aesirkth/launchpad-controller/(threads)

Thread 1 (2019-10-31):

Add new commands

wanysteus, 2019-10-31:
More commands must be added for Sigmundr

- Start the rocket fueling
- Ignite the rocket's engine
- Arm
- Defueling
- Activate/deactivate telemetry and FPV transmitters
- Start sensors calibration

Closed 2019-11-21.

Thread 13 (2020-08-28):

RadioHead library out of date

wanysteus, 2020-08-28:
We're currently using radiohead `1.61` modified by Paul Stoffregen [https://github.com/PaulStoffregen/RadioHead](https://github.com/PaulStoffregen/RadioHead)

This was done to test the code on a board where the LoRa chip is connected to SPI1 but is not needed anymore

We should use the latest version [https://www.airspayce.com/mikem/arduino/RadioHead/](https://www.airspayce.com/mikem/arduino/RadioHead/)

The update might break some things, `.lastRssi()` in particular
