aesirkth/launchpad-controller/src/controller.cpp

/* controller.cpp

Author: Erwan Caffier for ÆSIR

Version: v3.0

Date: August 2020

Description:
  Embedded software on the Launchpad Controller to control all of its outputs. The H-bridges are
  currently not implemented but the servo control and the main outputs are working well. This code
  has been tested on the Teensy LC microcontroller and the Launchpad Controller of the Mjollnir
  project.

License:
  MIT License

  Copyright (c) 2020 Association of Engineering Students in Rocketry

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
*/

#include "controller.h"

#include <Adafruit_NeoPixel.h>
#include <PWMServo.h>
#include <RH_RF95.h> // RadioHead library  to control the LoRa transceiver
#include <SPI.h>

#include "hardware_definition.h"
#include "utils.h"

#define BIT_RFM_INIT 0
#define BIT_OUTPUT1 1
#define BIT_OUTPUT2 2
#define BIT_OUTPUT3 3
#define BIT_OUTPUT4 4

#define SERVO_LIMIT_LOW 85
#define SERVO_LIMIT_HIGH 180

#define LIMIT_ACTIVATION
#define ACTIVATION_TIME 500

RH_RF95 rfm(PIN_RFM_NSS, digitalPinToInterrupt(PIN_RFM_INT));

Adafruit_NeoPixel strip = Adafruit_NeoPixel(NUM_RGB_LEDS, PIN_LED_CTRL, NEO_GRB + NEO_KHZ400);

PWMServo servo1, servo2, servo3;

uint8_t rfm_init_success = 0;
uint8_t output1_state = 0;
uint8_t output2_state = 0;
uint8_t output3_state = 0;
uint8_t output4_state = 0;
uint8_t servo1_angle = 0;
uint8_t servo2_angle = 0;
uint8_t servo3_angle = 0;

unsigned long was_activated_at[4];

char data[CMD_DATA_LEN];

void checkTimer();
void startTimer(uint8_t channel);

void setup()
{
  was_activated_at[0] = millis();
  was_activated_at[1] = millis();
  was_activated_at[2] = millis();
  was_activated_at[3] = millis();

  initRGB();
  initMainOutputs();
  initServos();

  initCommunications();

  analogReadRes(12);
}

void loop()
{
  if (getCommand(data))
  {
    switch (data[0])
    {
    case CMD_SEND_BONJOUR:
      Serial.println(BONJOUR);
      break;

    case CMD_TOGGLE_OUTPUT1:
      output1_state = data[1] & 0x01;
      digitalWrite(PIN_OUTPUT1, output1_state);

      if (output1_state == 1)
      {
        startTimer(1);
      }
      break;

    case CMD_TOGGLE_OUTPUT2:
      output2_state = data[1] & 0x01;
      digitalWrite(PIN_OUTPUT2, output2_state);
      if (output2_state == 1)
      {
        startTimer(2);
      }
      break;

    case CMD_TOGGLE_OUTPUT3:
      output3_state = data[1] & 0x01;
      digitalWrite(PIN_OUTPUT3, output3_state);
      if (output3_state == 1)
      {
        startTimer(3);
      }

      break;

    case CMD_TOGGLE_OUTPUT4:
      output4_state = data[1] & 0x01;
      digitalWrite(PIN_OUTPUT4, output4_state);
      if (output4_state == 1)
      {
        startTimer(4);
      }

      break;

    case CMD_MOVE_SERVO1:
      servo1_angle = constrain(data[1], SERVO_LIMIT_LOW, SERVO_LIMIT_HIGH);
      servo1.write(servo1_angle);
      break;

    case CMD_MOVE_SERVO2:
      servo2_angle = constrain(data[1], SERVO_LIMIT_LOW, SERVO_LIMIT_HIGH);
      servo2.write(servo2_angle);
      break;

    case CMD_MOVE_SERVO3:
      servo3_angle = constrain(data[1], SERVO_LIMIT_LOW, SERVO_LIMIT_HIGH);
      servo3.write(servo3_angle);
      break;

    default:
      break;
    }
    sendState();
  }

#ifdef LIMIT_ACTIVATION
  checkTimer();
#endif
}

void startTimer(uint8_t channel)
{
  was_activated_at[channel - 1] = millis();
}

void checkTimer()
{
  if (output1_state == 1 && (millis() - was_activated_at[0]) >= ACTIVATION_TIME)
  {
    output1_state = 0;
    digitalWrite(PIN_OUTPUT1, output1_state);
  }
  if (output2_state == 1 && (millis() - was_activated_at[1]) >= ACTIVATION_TIME)
  {
    output2_state = 0;
    digitalWrite(PIN_OUTPUT2, output2_state);
  }
  if (output3_state == 1 && (millis() - was_activated_at[2]) >= ACTIVATION_TIME)
  {
    output3_state = 0;
    digitalWrite(PIN_OUTPUT3, output3_state);
  }
  if (output4_state == 1 && (millis() - was_activated_at[3]) >= ACTIVATION_TIME)
  {
    output4_state = 0;
    digitalWrite(PIN_OUTPUT4, output4_state);
  }
}

void initRGB()
{
  strip.begin();
  delay(10);
  strip.clear();
  strip.setBrightness(20);
  strip.show();
  delay(100);
  strip.setPixelColor(0, STARTUP_COLOR);
  strip.show();
}

void initMainOutputs()
{
  pinMode(PIN_OUTPUT1, OUTPUT);
  pinMode(PIN_OUTPUT2, OUTPUT);
  pinMode(PIN_OUTPUT3, OUTPUT);
  pinMode(PIN_OUTPUT4, OUTPUT);

  digitalWrite(PIN_OUTPUT1, LOW);
  digitalWrite(PIN_OUTPUT2, LOW);
  digitalWrite(PIN_OUTPUT3, LOW);
  digitalWrite(PIN_OUTPUT4, LOW);
}

void initServos()
{
  servo1.attach(PIN_PWM1, SERVO_MIN_PULSE_WIDTH, SERVO_MAX_PULSE_WIDTH);
  servo2.attach(PIN_PWM2, SERVO_MIN_PULSE_WIDTH, SERVO_MAX_PULSE_WIDTH);
  servo3.attach(PIN_PWM3, SERVO_MIN_PULSE_WIDTH, SERVO_MAX_PULSE_WIDTH);
  servo1.write(SERVO_LIMIT_HIGH);
  servo2.write(SERVO_LIMIT_HIGH);
  servo3.write(SERVO_LIMIT_HIGH);
}

void resetRFM()
{
  pinMode(PIN_RFM_RESET, OUTPUT);
  digitalWrite(PIN_RFM_RESET, HIGH);
  delay(100);
  digitalWrite(PIN_RFM_RESET, LOW);
  delay(10);
  digitalWrite(PIN_RFM_RESET, HIGH);
  delay(100);
}

void initRFM()
{
  rfm_init_success = rfm.init();
  if (rfm_init_success)
  {
    // Defaults after init are 434.0MHz, 13dBm, Bw = 125 kHz, Cr = 4/5, Sf = 128chips/symbol, CRC on
    rfm.setFrequency(RFM_FREQ);
    rfm.setTxPower(RFM_TX_POWER, false);
  }
  showStatus();
}

void initCommunications()
{
  Serial.begin(BAUDRATE);

  resetRFM();
  initRFM();
}

void showStatus()
{
  if (not rfm_init_success)
  {
    strip.setPixelColor(0, 0xff0000);
  }
  else
  {
    strip.setPixelColor(0, 0x00ff00);
  }
  strip.show();
}

uint8_t getCommand(char *data)
{
  if (rfm_init_success)
  {
    if (rfm.waitAvailableTimeout(100))
    {
      uint8_t rf95_buf[RH_RF95_MAX_MESSAGE_LEN];
      uint8_t rf95_len = sizeof(rf95_buf);

      if (rfm.recv(rf95_buf, &rf95_len))
      {
        for (uint8_t i = 0; i < CMD_DATA_LEN; i++)
        {
          data[i] = rf95_buf[i];
        }
        strip.setPixelColor(0, 0xff0000);
        strip.show();
        delay(30);
        showStatus();
      }
      return 1;
    }
    else
    {
      return getSerialCommand(Serial, data); // Ignore the ID
    }
  }
  else
  {
    return getSerialCommand(Serial, data); // Ignore the ID
  }
}

void sendState()
{ // Get the current state of the Launch Pad Station Board and
  // send it to the control interface
  uint8_t state = 0;
  state = state | rfm_init_success << BIT_RFM_INIT;
  state = state | output1_state << BIT_OUTPUT1;
  state = state | output2_state << BIT_OUTPUT2;
  state = state | output3_state << BIT_OUTPUT3;
  state = state | output4_state << BIT_OUTPUT4;

  int8_t rssi;
  if (rfm_init_success)
  {
    rssi = rfm.lastRssi();
  }
  else
  {
    rssi = 0;
  }

  int16_t battery1 = analogRead(PIN_BAT1);
  uint8_t battery1_msb = (battery1 & 0xFF00) >> 8;
  uint8_t battery1_lsb = battery1 & 0x00FF;

  int16_t battery2 = analogRead(PIN_BAT2);
  uint8_t battery2_msb = (battery2 & 0xFF00) >> 8;
  uint8_t battery2_lsb = battery2 & 0x00FF;

  uint8_t m_size = 9;
  uint8_t message[m_size];

  message[0] = state;
  message[1] = servo1_angle;
  message[2] = servo2_angle;
  message[3] = servo3_angle;
  message[4] = battery1_msb;
  message[5] = battery1_lsb;
  message[6] = battery2_msb;
  message[7] = battery2_lsb;
  message[8] = rssi;

  if (rfm_init_success)
  {
    strip.setPixelColor(0, 0x0000ff);
    strip.show();
    delay(20);
    rfm.send(message, m_size);
    rfm.waitPacketSent();
    showStatus();
  }

  Serial.write(message, m_size);
  Serial.write(0x00);
  // Include a carriage return and a line feed so the receiver can split out frames
  Serial.write(0x0D);
  Serial.write(0x0A);
}
