aesirkth/launchpad-controller/include/hardware_definition.h

/* Pinout */
// Board outputs
#define PIN_OUTPUT1 1    // P1 on the board
#define PIN_OUTPUT2 A11  // P2 on the board
#define PIN_OUTPUT4 A10  // P3 on the board
#define PIN_OUTPUT3 23   // P4 on the board switcheroo
#define PIN_PWM1 16      // P5 on the board
#define PIN_PWM2 20      // P6 on the board
#define PIN_PWM3 22      // P7 on the board
#define PIN_IN1_B1 7
#define PIN_IN2_B1 8
#define PIN_IN1_B2 5
#define PIN_IN2_B2 6
#define PIN_IN1_B3 3
#define PIN_IN2_B3 4
// SPI bus pins
#define PIN_MOSI 11
#define PIN_MISO 12
#define PIN_SCK 13
// LoRa modem
#define PIN_RFM_RESET 9
#define PIN_RFM_NSS 10
#define PIN_RFM_INT 14
// RGB led
#define PIN_LED_CTRL 17
// Battery voltages
#define PIN_BAT1 19
#define PIN_BAT2 18

/* Other definitions */
#define NUM_RGB_LEDS 1
