aesirkth/launchpad-controller/(commit log)

2019-11-09 doc: fix relay number
2019-11-22 add lps gateway arduino code
2019-11-22 doc: update wiring instructions
2019-11-22 doc: add 5V and GND for relays in setup
2020-07-19 add pin definition
2020-07-20 working sketch with PlatformIO and Teensy LC
2020-07-21 doc: refactor doc for new board
2020-07-23 doc: add board capacities
2020-07-23 add unit test for servos
2020-07-23 add servo control
2020-07-28 add servo angle return
2020-07-29 doc: document returned frame
2020-07-29 add battery readout
2020-10-23 Implementation of time limit on all high voltage channels
2020-10-29 Changed time measurement from clock() to millis() and thus removed dependancy on time.h library.
2020-11-01 Added commas where they where missing
    [controller.cpp]
2020-11-01 Fixed typos and tested code on the launchpad controller board
    [controller.cpp]
2021-03-23 Added servo limits and idle
2021-09-15 switch output 3 and 4
